vchernokulsky/ESP32-ACCEL_GYRO/ReadMe.txt

Структура проекта:

hardware - проект разработанного устройства для САПР KiCad

firmware - исходники прошивки для устройства (Micropython)

software - исходники приложения для сбора данных (Microsoft Visual Studio 2019 / C# WPF)
