vchernokulsky/ESP32-ACCEL_GYRO/hardware/BDSM.kicad_pcb

## KiCad design hardware/BDSM.kicad_pcb (2020-10-30)

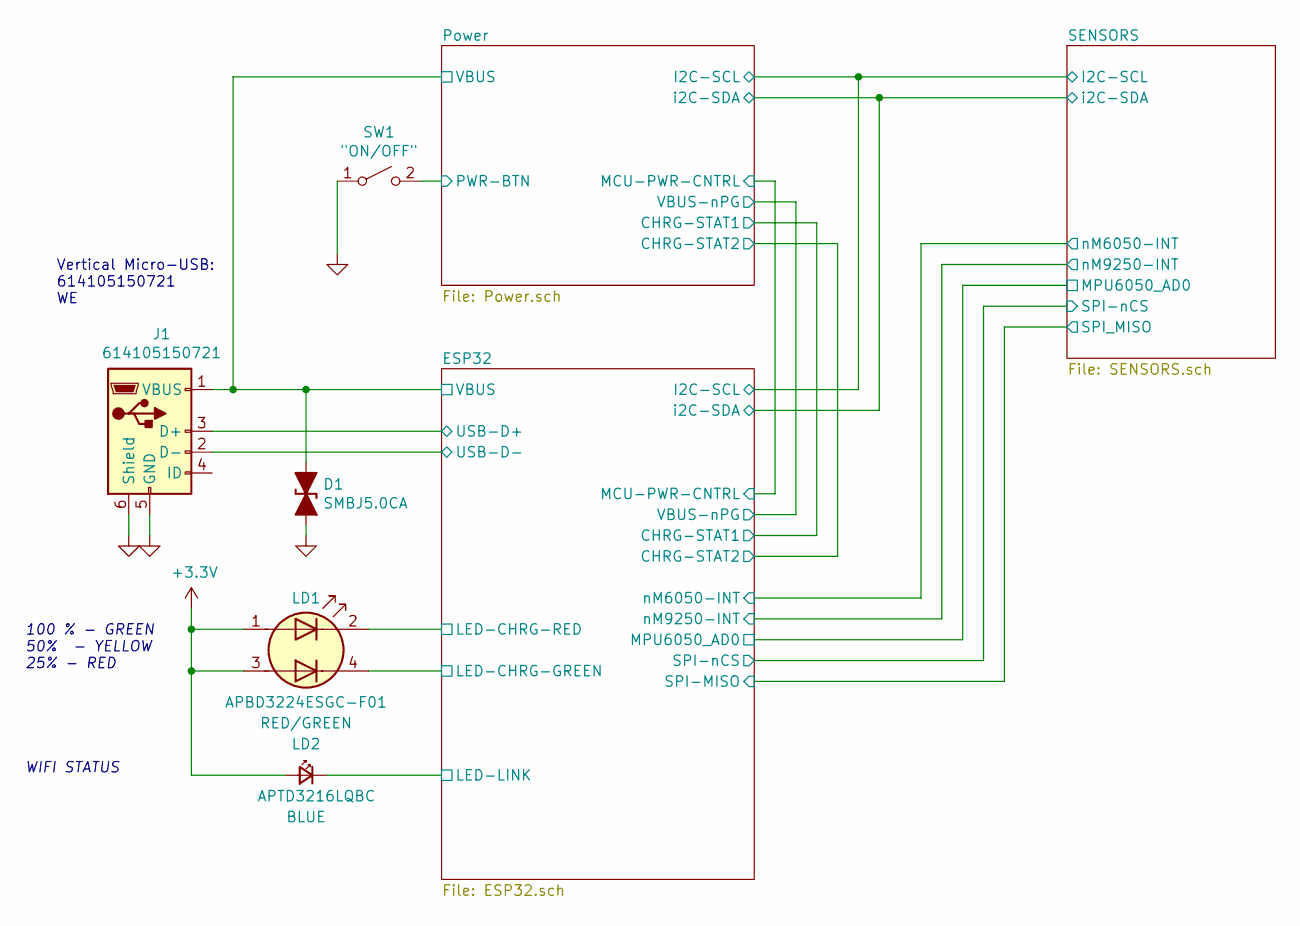
[picture p1: schematic BDSM.sch]

Parts:
D1: SMBJ5.0CA; D_SMB; PartNumber SMBJ5.0CA
J1: 614105150721; USB_Micro-B_Wuerth_614105150721_Vertical; PartNumber 614105150721
LD1: RED/GREEN; LED_Kingbright_APBD3224ESGC; PartNumber APBD3224ESGC-F01
LD2: BLUE; LED_1206_3216Metric_Pad1.42x1.75mm_HandSolder; PartNumber APTD3216LQBC
SW1: \"ON/OFF\"; Switch_Tactile_SMD_6x6mm; PartNumber 5-1437565-0

Connections:
+3V3: LD1.1 (A1), LD1.3 (A2), LD2.2 (A); also elsewhere on the board
/ESP32/LED-CHRG-GREEN: LD1.4 (K2); also elsewhere on the board
/ESP32/LED-CHRG-RED: LD1.2 (K1); also elsewhere on the board
/ESP32/LED-LINK: LD2.1 (K); also elsewhere on the board
/ESP32/USB-D+: J1.3 (D+); also elsewhere on the board
/ESP32/USB-D-: J1.2 (D-); also elsewhere on the board
/ESP32/VBUS: D1.1 (A1), J1.1 (VBUS); also elsewhere on the board
/Power/PWR-BTN: SW1.2 (B); also elsewhere on the board
GNDA: D1.2 (A2), J1.5 (GND), J1.6 (Shield), SW1.1 (A); also elsewhere on the board

Notes on the sheet:
Vertical Micro-USB: 614105150721 WE
100 % - GREEN 50% - YELLOW 25% - RED
WIFI STATUS

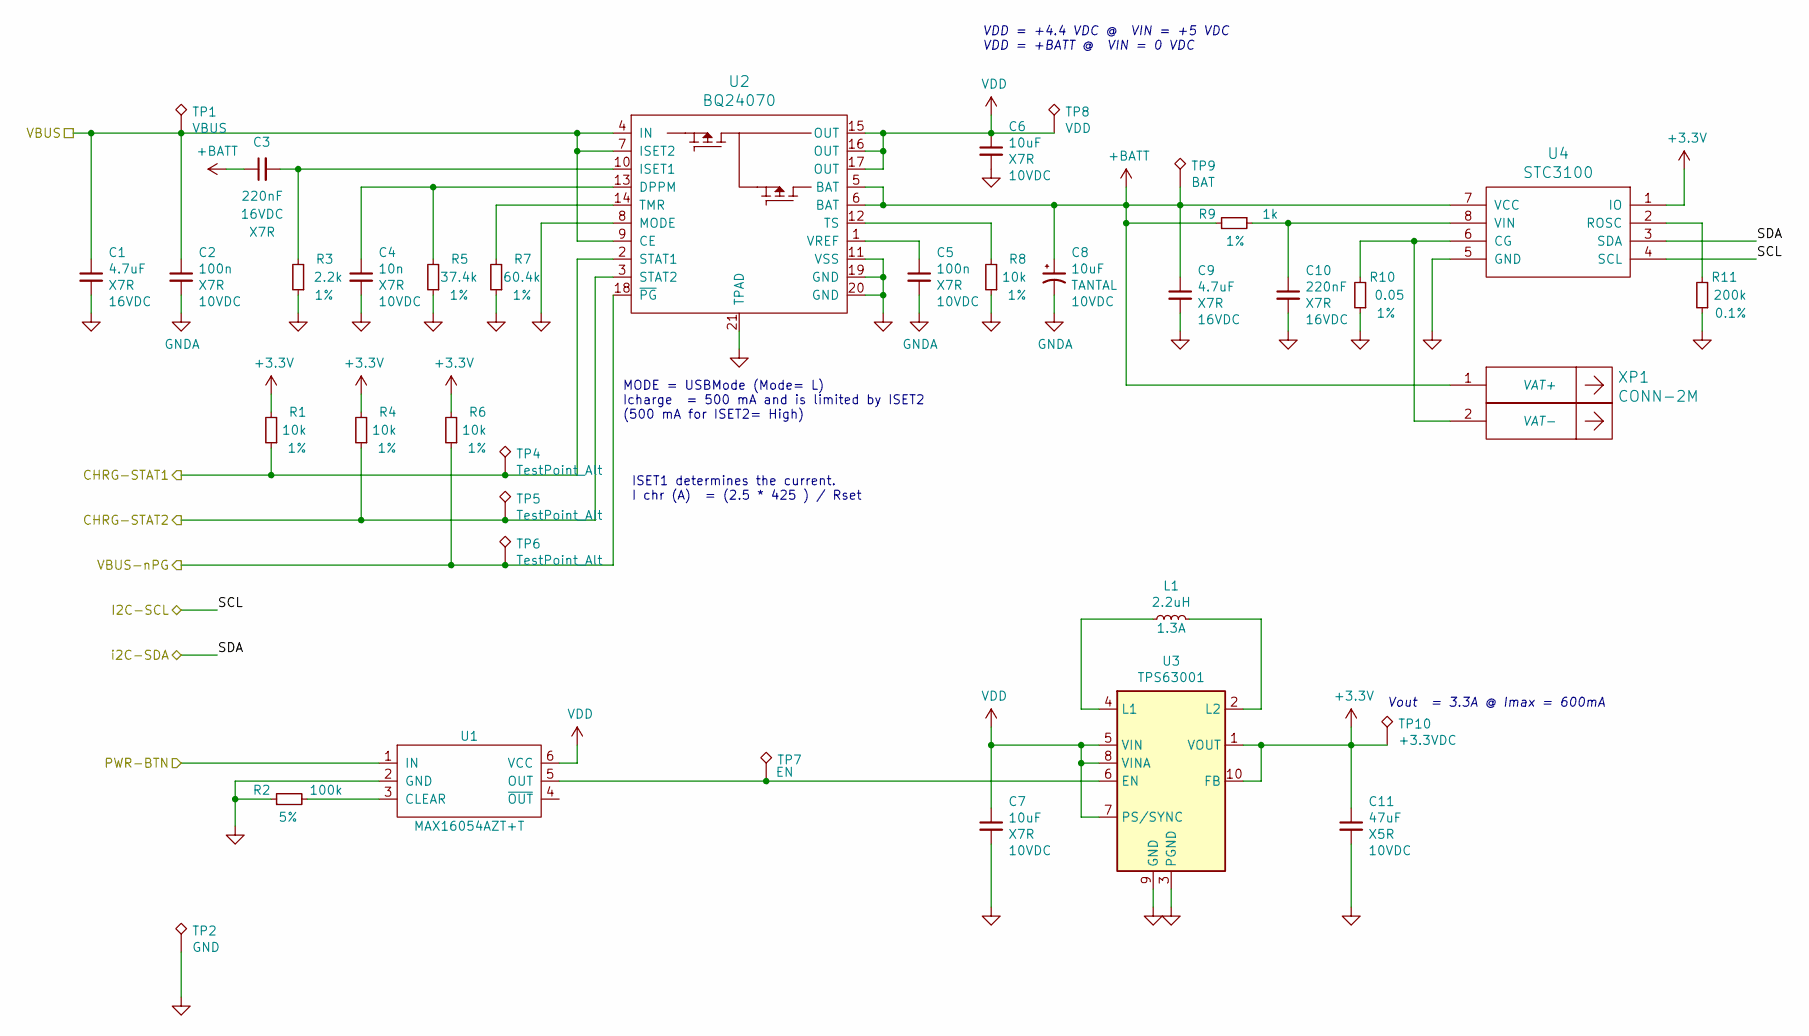
[picture p2: schematic Power.sch]

Parts:
C1, C9: 4.7uF; C_0805_2012Metric; Tolerance X7R; PartNumber CC0805KKX7R7BB105
C2, C5: 100n; C_0603_1608Metric; Tolerance X7R; PartNumber CC0603KRX7R9BB104
C3, C10: 220nF; C_0603_1608Metric; Tolerance X7R; PartNumber CC0603KRX7R7BB224
C4: 10n; C_0603_1608Metric; Tolerance X7R; PartNumber CC0603KRX7R9BB103
C6, C7: 10uF; C_0805_2012Metric; Tolerance X7R; PartNumber CL21B106KOQNNNE
C8: 10uF; CP_EIA-3528-21_Kemet-B; Tolerance TANTAL; PartNumber TAJB106K010RNJ
C11: 47uF; C_1206_3216Metric; Tolerance X5R; PartNumber C3216X5R1C476M160AB
L1: 2.2uH; L_1008_2520Metric; PartNumber LQM2HPN2R2MG0L
R1, R4, R6, R8: 10k; R_0603_1608Metric; Tolerance 1%; PartNumber RC0603FR-0710KL
R2: 100k; R_0603_1608Metric; Tolerance 5%; PartNumber RC0603JR-07100KL
R3: 2.2k; R_0603_1608Metric; Tolerance 1%; PartNumber RC0603FR-072K2L
R5: 37.4k; R_0603_1608Metric; Tolerance 1%; PartNumber RC0603FR-0737K4L
R7: 60.4k; R_0603_1608Metric; Tolerance 1%; PartNumber RC0603FR-0760K4L
R9: 1k; R_0603_1608Metric; Tolerance 1%; PartNumber CRCW06031K00FKEA
R10: 0.05; R_1206_3216Metric; Tolerance 1%; PartNumber RL1206FR-070R05L
R11: 200k; R_0603_1608Metric; Tolerance 0.1%; PartNumber RC0603FR-07200KL
TP1: VBUS; TestPoint_Pad_1.0x1.0mm; PartNumber PCB
TP2: GND; TestPoint_Keystone_5019_Minature; PartNumber PCB
TP4, TP5, TP6: TestPoint_Alt; TestPoint_Pad_1.0x1.0mm; PartNumber PCB
TP7: EN; TestPoint_Pad_1.0x1.0mm; PartNumber PCB
TP8: VDD; TestPoint_Pad_1.0x1.0mm; PartNumber PCB
TP9: BAT; TestPoint_Pad_1.0x1.0mm; PartNumber PCB
TP10: +3.3VDC; TestPoint_Pad_1.0x1.0mm; PartNumber PCB
U1: MAX16054AZT+T; SOT-23-6; PartNumber MAX16054AZT+T
U2: BQ24070; Texas_VQFN-RHL-20_ThermalVias; PartNumber BQ24070RHLR
U3: TPS63001; Texas_DRC0010J_ThermalVias; PartNumber TPS63001DRCT
U4: STC3100; MSOP-8_3x3mm_P0.65mm; PartNumber STC3100IST
XP1: CONN-2M; CWF-2R; PartNumber CWF-2R

Connections:
+3V3: C11.1, R1.2, R4.2, R6.2, TP10.1, U3.1 (VOUT), U3.10 (FB), U4.1 (IO); also elsewhere on the board
+BATT: C3.1, C8.1, C9.1, R9.2, TP9.1, U2.5 (BAT), U2.6 (BAT), U4.7 (VCC), XP1.1
/ESP32/CHRG-STAT1: R1.1, TP4.1, U2.2 (STAT1); also elsewhere on the board
/ESP32/CHRG-STAT2: R4.1, TP5.1, U2.3 (STAT2); also elsewhere on the board
/ESP32/I2C-SCL: U4.4 (SCL); also elsewhere on the board
/ESP32/VBUS: C1.1, C2.1, TP1.1, U2.4 (IN), U2.7 (ISET2), U2.9 (CE); also elsewhere on the board
/ESP32/VBUS-nPG: R6.1, TP6.1, U2.18 (~PG); also elsewhere on the board
/ESP32/i2C-SDA: U4.3 (SDA); also elsewhere on the board
/Power/PWR-BTN: U1.1 (IN); also elsewhere on the board
GNDA: C1.2, C2.2, C4.2, C5.2, C6.2, C7.2, C8.2, C9.2, C10.2, C11.2, R2.1, R3.1, R5.1, R7.1, R8.1, R10.1, R11.1, TP2.1, U1.2 (GND), U2.8 (MODE), U2.11 (VSS), U2.19 (GND), U2.20 (GND), U2.21 (TPAD), U3.3 (PGND), U3.9 (GND), U3.11 (PGND), U4.5 (GND); also elsewhere on the board
unnamed: C3.2, R3.2, U2.10 (ISET1)
unnamed: C4.1, R5.2, U2.13 (DPPM)
unnamed: C5.1, U2.1 (VREF)
unnamed: C10.1, R9.1, U4.8 (VIN)
unnamed: L1.1, U3.4 (L1)
unnamed: L1.2, U3.2 (L2)
unnamed: R2.2, U1.3 (CLEAR)
unnamed: R7.2, U2.14 (TMR)
unnamed: R8.2, U2.12 (TS)
unnamed: R10.2, U4.6 (CG), XP1.2
unnamed: R11.2, U4.2 (ROSC)
unnamed: TP7.1, U1.5 (OUT), U3.6 (EN)
VDD: C6.1, C7.1, TP8.1, U1.6 (VCC), U2.15 (OUT), U2.16 (OUT), U2.17 (OUT), U3.5 (VIN), U3.7 (PS/SYNC), U3.8 (VINA)

Notes on the sheet:
VDD = +4.4 VDC @ VIN = +5 VDC VDD = +BATT @ VIN = 0 VDC
ISET1 determines the current. I chr (A) = (2.5 * 425 ) / Rset
MODE = USBMode (Mode= L) Icharge = 500 mA and is limited by ISET2 (500 mA for ISET2= High)
Vout = 3.3A @ Imax = 600mA

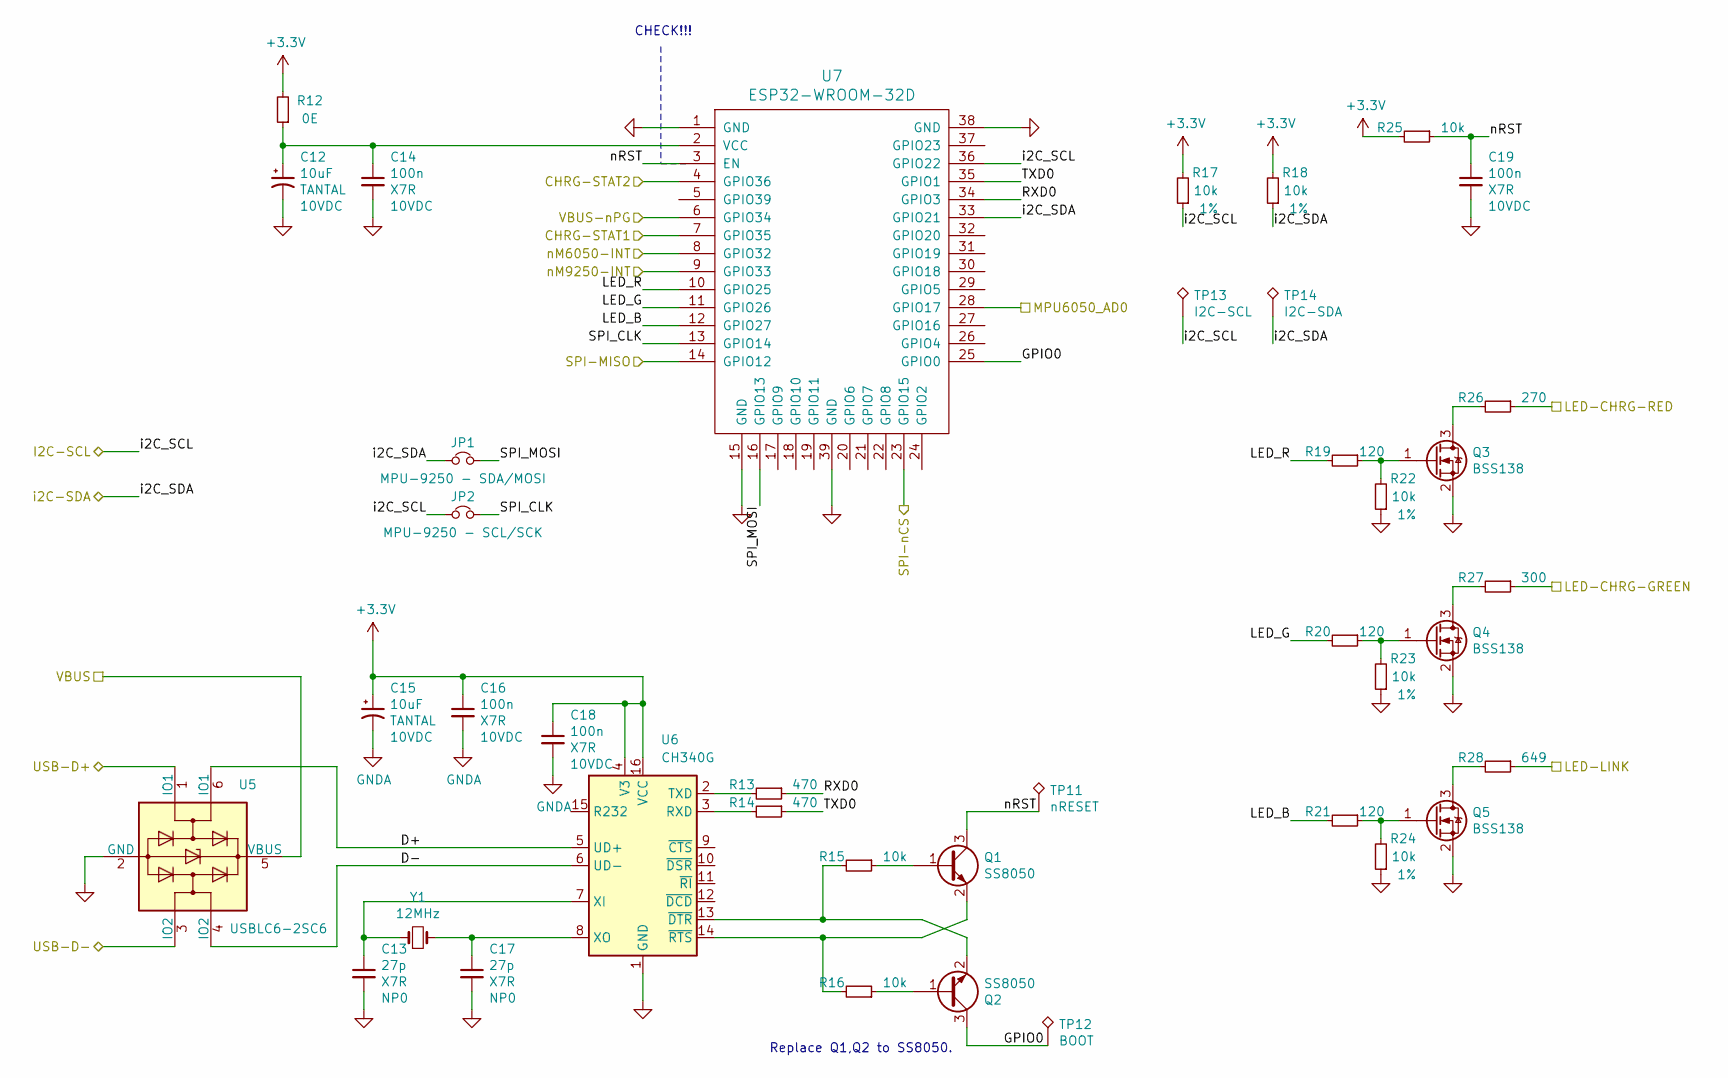
[picture p3: schematic ESP32.sch]

Parts:
C12, C15: 10uF; CP_EIA-3528-21_Kemet-B; Tolerance TANTAL; PartNumber TAJB106K010RNJ
C13, C17: 27p; C_0603_1608Metric; Tolerance X7R; PartNumber CC0603JRNPO9BN270
C14, C16, C18, C19: 100n; C_0603_1608Metric; Tolerance X7R; PartNumber CC0603KRX7R9BB104
JP1: MPU-9250 - SDA/MOSI; SolderJumper-2_P1.3mm_Open_TrianglePad1.0x1.5mm; PartNumber PCB
JP2: MPU-9250 - SCL/SCK; SolderJumper-2_P1.3mm_Open_TrianglePad1.0x1.5mm; PartNumber PCB
Q1, Q2: SS8050; SOT-23; PartNumber SS8050
Q3, Q4, Q5: BSS138; SOT-23; PartNumber BSS138LT1G
R12: 0E; R_0603_1608Metric; PartNumber RC0603FR-070RL
R13, R14: 470; R_0603_1608Metric; PartNumber RC0603FR-07470RL
R15, R16, R25: 10k; R_0603_1608Metric; PartNumber RC0603FR-0710KL
R17, R18, R22, R23, R24: 10k; R_0603_1608Metric; Tolerance 1%; PartNumber RC0603FR-0710KL
R19, R20, R21: 120; R_0603_1608Metric; PartNumber RC0603FR-07120RL
R26: 270; R_0603_1608Metric; PartNumber RC0603FR-07270RL
R27: 300; R_0603_1608Metric; PartNumber RC0603FR-07300RL
R28: 649; R_0603_1608Metric; PartNumber RC0603FR-07649RL
TP11: nRESET; TestPoint_Pad_1.0x1.0mm; PartNumber PCB
TP12: BOOT; TestPoint_Pad_1.0x1.0mm; PartNumber PCB
TP13: I2C-SCL; TestPoint_Pad_2.0x2.0mm; PartNumber PCB
TP14: I2C-SDA; TestPoint_Pad_2.0x2.0mm; PartNumber PCB
U5: USBLC6-2SC6; SOT-23-6; PartNumber USBLC6-2SC6
U6: CH340G; SOIC-16_3.9x9.9mm_P1.27mm; PartNumber CH340G
U7: ESP32-WROOM-32D; PartNumber ESP32-WROOM-32D
Y1: 12MHz; ABM3; PartNumber ABM3-12.000MHZ-D2Y-T

Connections:
+3V3: C15.1, C16.1, C18.1, R12.2, R17.2, R18.2, R25.2, U6.4 (V3), U6.16 (VCC); also elsewhere on the board
/ESP32/CHRG-STAT1: U7.7 (GPIO35); also elsewhere on the board
/ESP32/CHRG-STAT2: U7.4 (GPIO36); also elsewhere on the board
/ESP32/D+: U5.6 (IO1), U6.5 (UD+)
/ESP32/D-: U5.4 (IO2), U6.6 (UD-)
/ESP32/GPIO0: Q2.3 (C), TP12.1, U7.25 (GPIO0)
/ESP32/I2C-SCL: JP2.1, R17.1, TP13.1, U7.36 (GPIO22); also elsewhere on the board
/ESP32/LED-CHRG-GREEN: R27.1; also elsewhere on the board
/ESP32/LED-CHRG-RED: R26.1; also elsewhere on the board
/ESP32/LED-LINK: R28.1; also elsewhere on the board
/ESP32/LED_B: R21.2, U7.12 (GPIO27)
/ESP32/LED_G: R20.2, U7.11 (GPIO26)
/ESP32/LED_R: R19.2, U7.10 (GPIO25)
/ESP32/MPU6050_AD0: U7.28 (GPIO17); also elsewhere on the board
/ESP32/RXD0: R13.1, U7.34 (GPIO3)
/ESP32/SPI-MISO: U7.14 (GPIO12); also elsewhere on the board
/ESP32/SPI-nCS: U7.23 (GPIO15); also elsewhere on the board
/ESP32/SPI_CLK: JP2.2, U7.13 (GPIO14)
/ESP32/SPI_MOSI: JP1.2, U7.16 (GPIO13)
/ESP32/TXD0: R14.1, U7.35 (GPIO1)
/ESP32/USB-D+: U5.1 (IO1); also elsewhere on the board
/ESP32/USB-D-: U5.3 (IO2); also elsewhere on the board
/ESP32/VBUS: U5.5 (VBUS); also elsewhere on the board
/ESP32/VBUS-nPG: U7.6 (GPIO34); also elsewhere on the board
/ESP32/i2C-SDA: JP1.1, R18.1, TP14.1, U7.33 (GPIO21); also elsewhere on the board
/ESP32/nM6050-INT: U7.8 (GPIO32); also elsewhere on the board
/ESP32/nM9250-INT: U7.9 (GPIO33); also elsewhere on the board
/ESP32/nRST: C19.1, Q1.3 (C), R25.1, TP11.1, U7.3 (EN)
GNDA: C12.2, C13.2, C14.2, C15.2, C16.2, C17.2, C18.2, C19.2, Q3.2 (S), Q4.2 (S), Q5.2 (S), R22.1, R23.1, R24.1, U5.2 (GND), U6.1 (GND), U7.1 (GND), U7.15 (GND), U7.38 (GND), U7.39 (GND); also elsewhere on the board
unnamed: C12.1, C14.1, R12.1, U7.2 (VCC)
unnamed: C13.1, U6.7 (XI), Y1.1
unnamed: C17.1, U6.8 (XO), Y1.2
unnamed: Q1.1 (B), R15.1
unnamed: Q1.2 (E), R16.2, U6.14 (~RTS)
unnamed: Q2.1 (B), R16.1
unnamed: Q2.2 (E), R15.2, U6.13 (~DTR)
unnamed: Q3.1 (G), R19.1, R22.2
unnamed: Q3.3 (D), R26.2
unnamed: Q4.1 (G), R20.1, R23.2
unnamed: Q4.3 (D), R27.2
unnamed: Q5.1 (G), R21.1, R24.2
unnamed: Q5.3 (D), R28.2
unnamed: R13.2, U6.2 (TXD)
unnamed: R14.2, U6.3 (RXD)

Notes on the sheet:
CHECK!!!
Replace Q1,Q2 to SS8050.

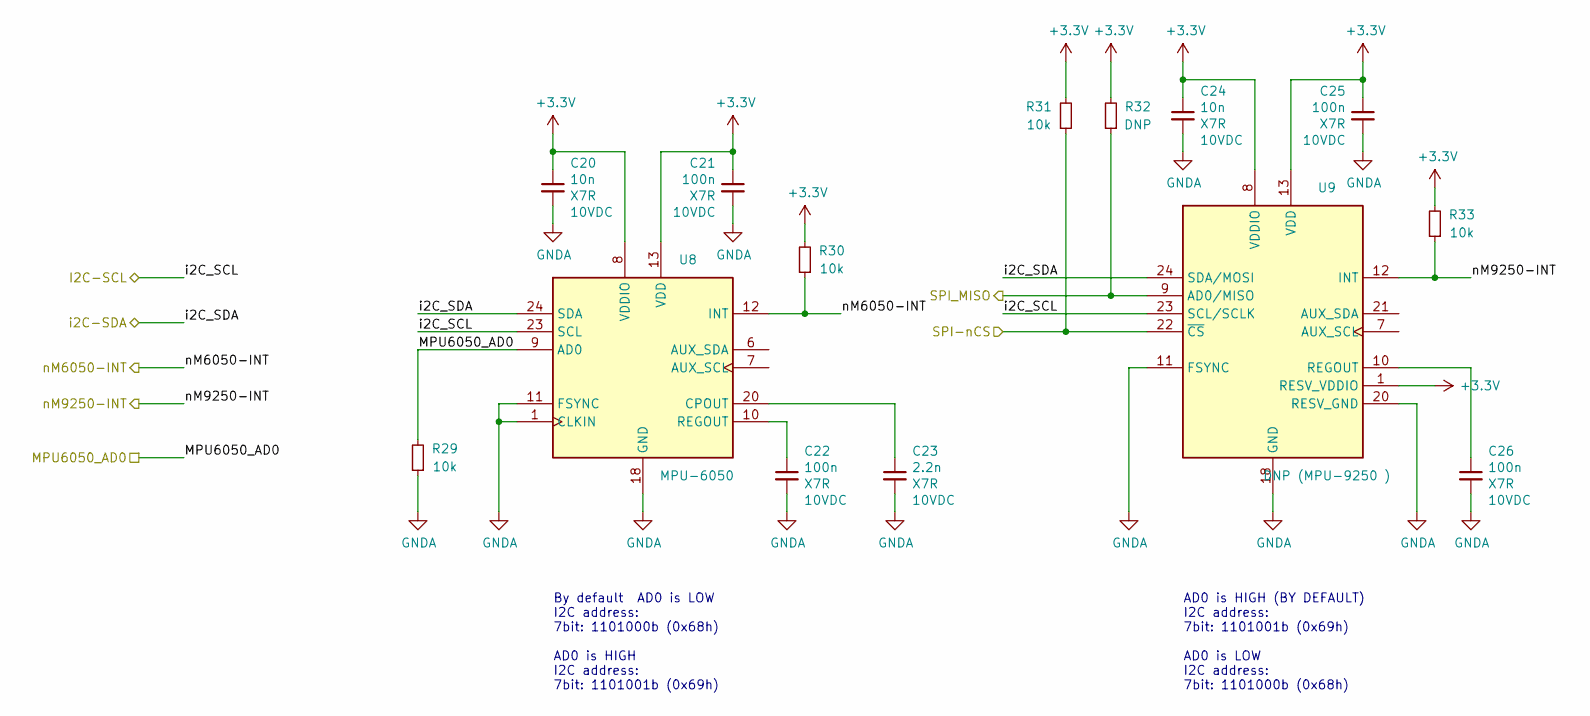
[picture p4: schematic SENSORS.sch]

Parts:
C20, C24: 10n; C_0603_1608Metric; Tolerance X7R; PartNumber CC0603KRX7R9BB103
C21, C22, C25, C26: 100n; C_0603_1608Metric; Tolerance X7R; PartNumber CC0603KRX7R9BB104
C23: 2.2n; C_0603_1608Metric; Tolerance X7R; PartNumber GRM188R71C222KA01D
R29, R30, R31, R33: 10k; R_0603_1608Metric; PartNumber RC0603FR-0710KL
R32: DNP; R_0603_1608Metric; PartNumber DNP
U8: MPU-6050; InvenSense_QFN-24_4x4mm_P0.5mm; PartNumber MPU-6050
U9: DNP (MPU-9250 ); InvenSense_QFN-24_3x3mm_P0.4mm; PartNumber DNP

Connections:
+3V3: C20.1, C21.1, C24.1, C25.1, R30.2, R31.2, R32.2, R33.2, U8.8 (VDDIO), U8.13 (VDD), U9.1 (RESV_VDDIO), U9.8 (VDDIO), U9.13 (VDD); also elsewhere on the board
/ESP32/I2C-SCL: U8.23 (SCL), U9.23 (SCL/SCLK); also elsewhere on the board
/ESP32/MPU6050_AD0: R29.2, U8.9 (AD0); also elsewhere on the board
/ESP32/SPI-MISO: R32.1, U9.9 (AD0/MISO); also elsewhere on the board
/ESP32/SPI-nCS: R31.1, U9.22 (~CS); also elsewhere on the board
/ESP32/i2C-SDA: U8.24 (SDA), U9.24 (SDA/MOSI); also elsewhere on the board
/ESP32/nM6050-INT: R30.1, U8.12 (INT); also elsewhere on the board
/ESP32/nM9250-INT: R33.1, U9.12 (INT); also elsewhere on the board
GNDA: C20.2, C21.2, C22.2, C23.2, C24.2, C25.2, C26.2, R29.1, U8.1 (CLKIN), U8.11 (FSYNC), U8.18 (GND), U9.11 (FSYNC), U9.18 (GND), U9.20 (RESV_GND); also elsewhere on the board
unnamed: C22.1, U8.10 (REGOUT)
unnamed: C23.1, U8.20 (CPOUT)
unnamed: C26.1, U9.10 (REGOUT)

Notes on the sheet:
By default AD0 is LOW I2C address: 7bit: 1101000b (0x68h) AD0 is HIGH I2C address: 7bit: 1101001b (0x69h)
AD0 is HIGH (BY DEFAULT) I2C address: 7bit: 1101001b (0x69h) AD0 is LOW I2C address: 7bit: 1101000b (0x68h)

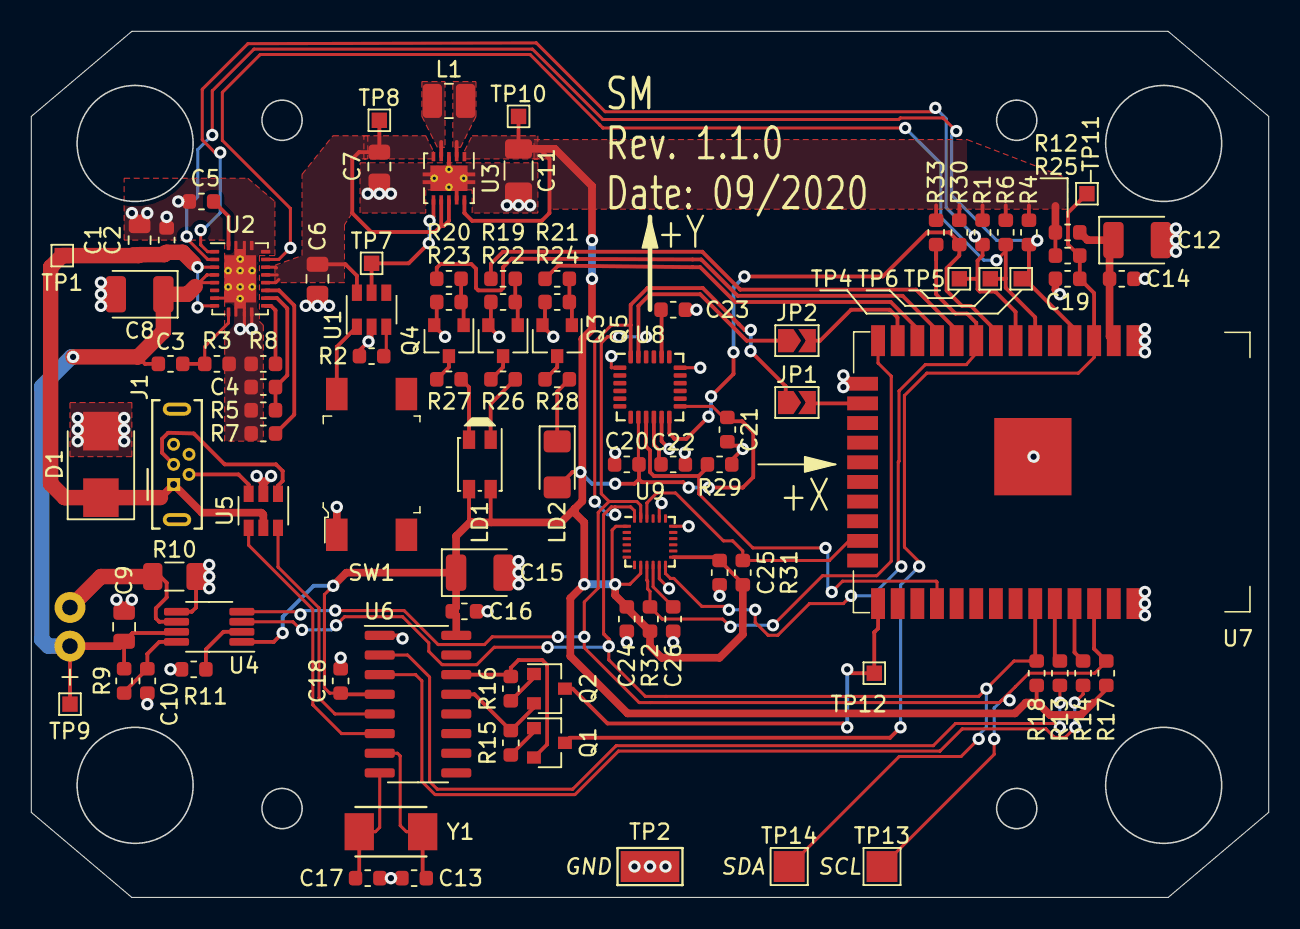
[picture p5: board BDSM.kicad_pcb from above]

Board: 2 copper layers, 80.0 x 56.0 mm, 96 parts (1 on the bottom side), 62 nets.
