vchernokulsky/ESP32-ACCEL_GYRO/(commit log)

2020-07-03 firmware add acceleration reading sending to socket
2020-07-03 handle socket error
2020-07-03 add SocketServer port configuration from argv
2020-07-03 indicate socket connection by led blinkinh
2020-07-06 udp example for esp32
2020-07-07 device info server sync
2020-07-07 add syncronization with devices
2020-07-08 add device simulator
2020-07-08 c# receive data from esp with start-stop buttons
2020-07-08 fix receiving data from esp
    [main.py]
2020-07-09 reform data_receiver usage for multiple devices
2020-07-10 fix acc gyro info converter
    [Accelerometer.py, main.py]
2020-07-14 Fix incorrect package sequence
    [main.py]
2020-07-14 convert gyro to deg/s
2020-07-15 esp32 autostart
2020-07-15 make DeviceSyncronizer non static
2020-07-15 finish threads
2020-07-15 esp32 add calibration class
2020-07-15 calibrate values
2020-07-17 add buttons
2020-07-17 try to bind with device syncronizer
2020-07-24 create user control for Chart with buttons
2020-07-27 create model and control for prev/next button
2020-07-29 rename ImuServer namespace
2020-08-03 esp32: send calibration info
2020-08-03 wpf: get calibration info
2020-08-04 do not get data from extra devices in Angles measurement app
2020-08-04 add config file and led blinking on calibration
2020-08-05 add led for charge state
2020-08-05 add show chart button
2020-09-04 Add ESP device schematic
2020-09-25 Add first hardware version
    [BDSM.csv, BDSM.kicad_pcb, BDSM.sch, ESP32.sch, Power.sch, SENSORS.sch, USB.sch]
2020-09-25 ChargeMonitor - add charge state descriptions Config - revert default values main - simple refactoring
    [ChargeMonitor.py, main.py]
2020-09-25 Add gravity correction for device number 4
2020-09-25 Fix ESP32 powering errors
    [BDSM.kicad_pcb, BDSM.sch, ESP32.sch, Power.sch, SENSORS.sch]
2020-10-23 Update ESP32.lib and gyro_data_processing.py
